LinJesUxUs/TermoHumi/KiCad/TermoHumi/TermoHumi.kicad_pcb

## KiCad design KiCad/TermoHumi/TermoHumi.kicad_pcb (2026-10-09)

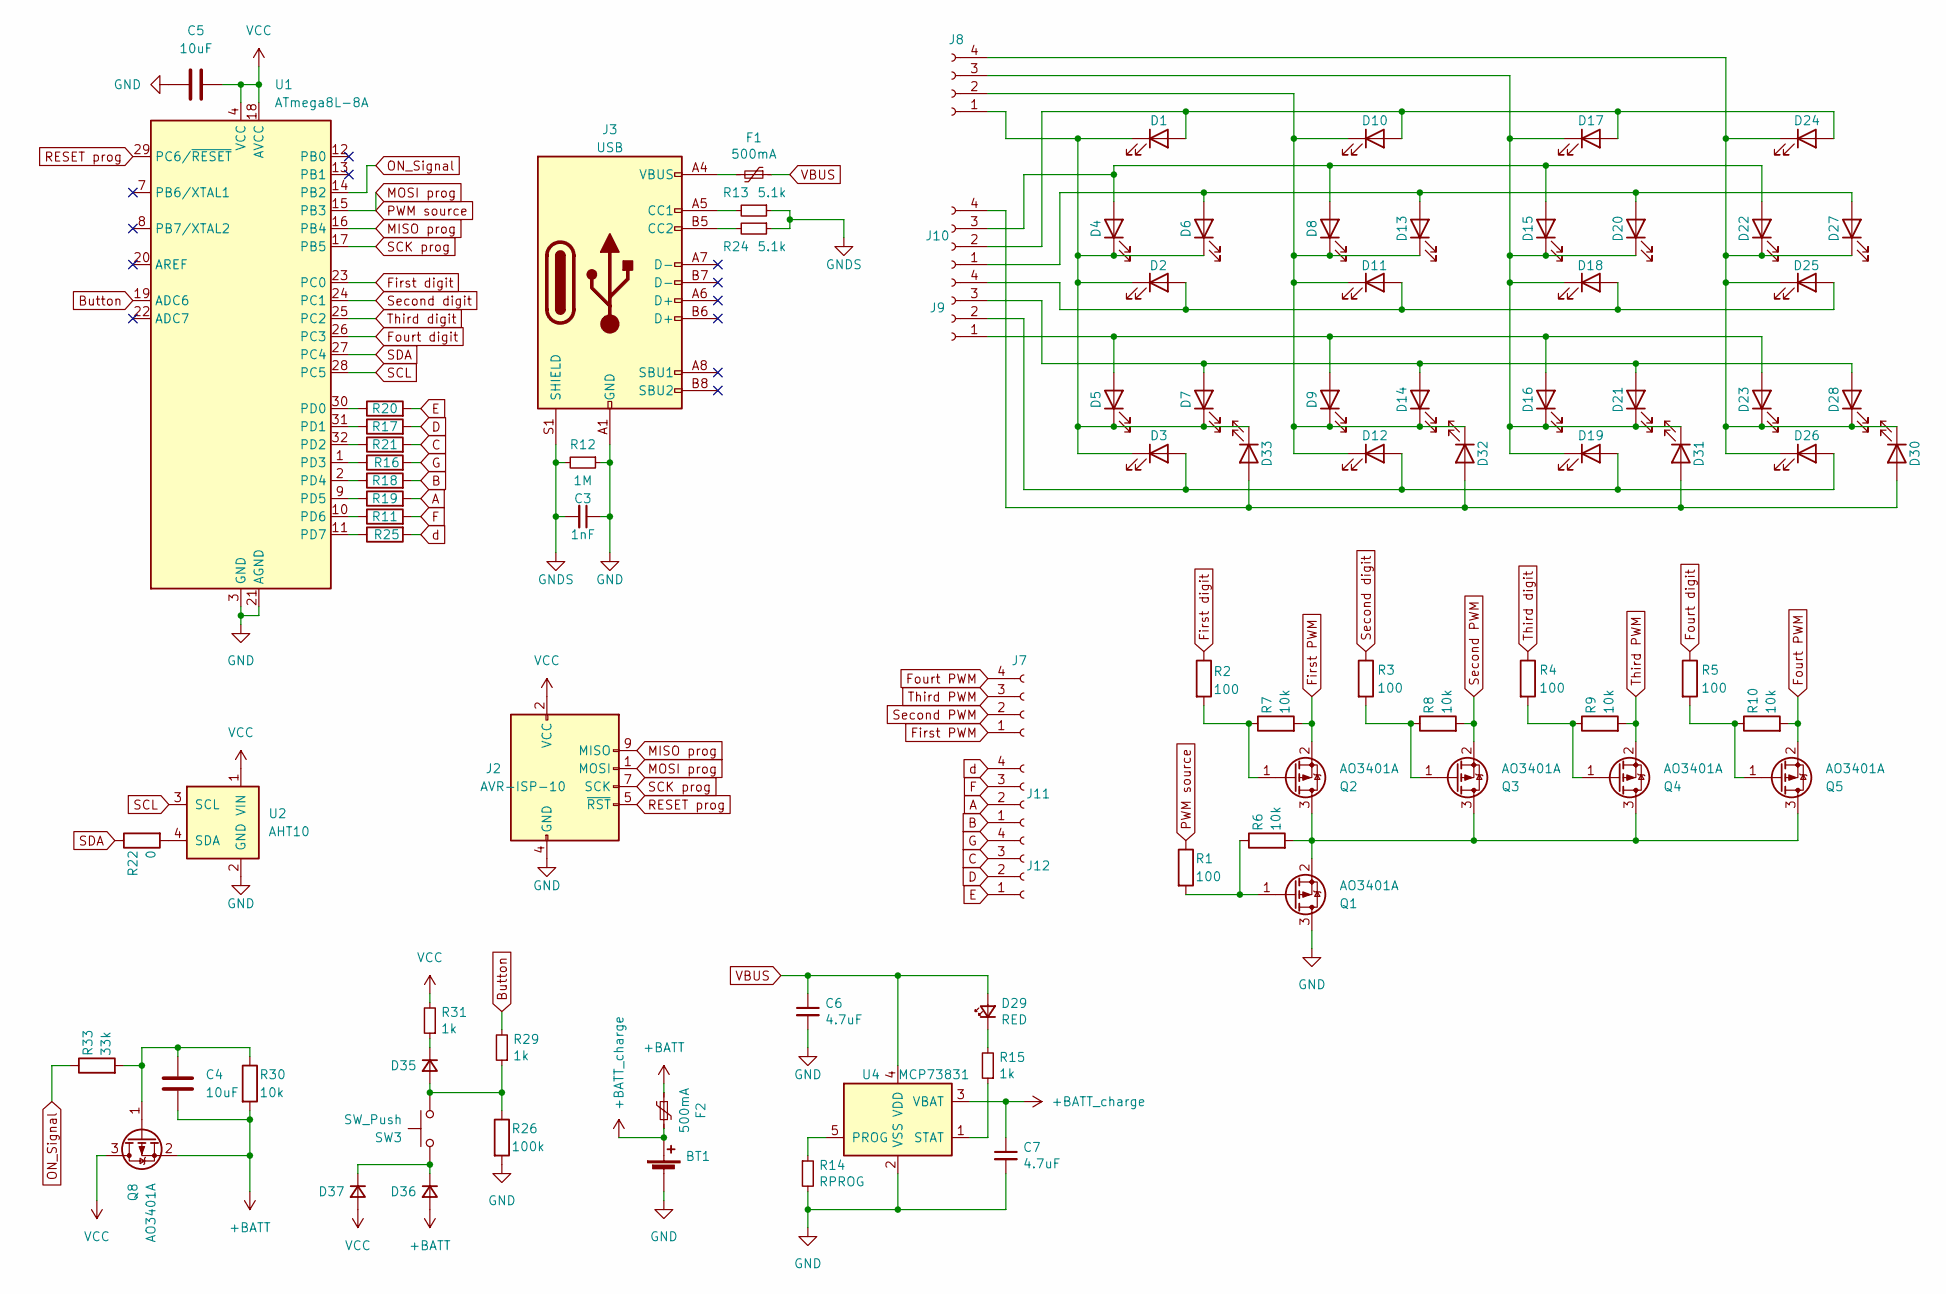
[picture p1: schematic TermoHumi.kicad_sch]

Parts:
BT1: Battery_Cell; PinHeader_1x02_P2.54mm_Vertical
C3: 1nF; C_0603_1608Metric_Pad1.08x0.95mm_HandSolder; LCSC C1588
C4, C5: 10uF; C_0603_1608Metric_Pad1.08x0.95mm_HandSolder
C6, C7: 4.7uF; C_0603_1608Metric_Pad1.08x0.95mm_HandSolder; LCSC C19666
D1, D2, D3, D4, D5, D6, D7, D8, D9, D10, D11, D12, D13, D14, D15, D16, D17, D18, D19, D20, D21, D22, D23, D24, D25, D26, D27, D28, D30, D31, D32, D33: LED; LED_1606_4015Metric_Pad1.42x1.75mm_HandSolder
D29: RED; LED_1606_4015Metric_Pad1.42x1.75mm_HandSolder; LCSC C2286
D35, D36, D37: 1N4148WS; D_SOD-323_HandSoldering; LCSC C57759
F1, F2: 500mA; Fuse_1206_3216Metric_Pad1.42x1.75mm_HandSolder; LCSC C355568
J2: AVR-ISP-10; PinHeader_2x05_P2.54mm_Vertical
J3: USB; USB-C_C168688
J7, J8, J9, J10, J11, J12: Conn_01x04_Socket; PinHeader_1x04_P2.54mm_Vertical
Q1, Q2, Q3, Q4, Q5, Q8: AO3401A; SOT-23
R1, R2, R3, R4, R5: 100; R_0603_1608Metric_Pad0.98x0.95mm_HandSolder
R6, R7, R8, R9, R10, R30: 10k; R_0603_1608Metric_Pad0.98x0.95mm_HandSolder
R11, R16, R17, R18, R19, R20, R21, R25: 220; R_0603_1608Metric_Pad0.98x0.95mm_HandSolder
R12: 1M; R_0603_1608Metric_Pad0.98x0.95mm_HandSolder; LCSC C22935
R13, R24: 5.1k; R_0603_1608Metric_Pad0.98x0.95mm_HandSolder; LCSC C23186
R14: RPROG; R_0603_1608Metric_Pad0.98x0.95mm_HandSolder; LCSC C22978
R15, R29, R31: 1k; R_0603_1608Metric_Pad0.98x0.95mm_HandSolder; LCSC C21190
R22: 0; R_0603_1608Metric_Pad0.98x0.95mm_HandSolder
R26: 100k; R_0603_1608Metric_Pad0.98x0.95mm_HandSolder
R33: 33k; R_0805_2012Metric_Pad1.20x1.40mm_HandSolder
SW3: SW_Push; TS-1086E_TopoR_Hack_HandSolder
U1: ATmega8L-8A; TQFP-32_7x7mm_P0.8mm
U2: AHT10; AHT10_module_x04_P2.54mm
U4: MCP73831; SOT-23-5_HandSoldering; LCSC C14879

Connections:
+BATT: C4.2, D36.2 (A), F2.2, Q8.2 (S), R30.2
+BATT_charge: BT1.1 (+), C7.1, F2.1, U4.3 (VBAT)
A: J11.2, R19.2
B: J11.1, R18.2
Button: R29.2, U1.19 (ADC6)
C: J12.3, R21.2
D: J12.2, R17.2
E: J12.1, R20.2
F: J11.3, R11.2
First PWM: J7.1, Q2.2 (S), R7.2
First digit: R2.1, U1.23 (PC0)
Fourt PWM: J7.4, Q5.2 (S), R10.2
Fourt digit: R5.1, U1.26 (PC3)
G: J12.4, R16.2
GND: BT1.2 (-), C3.1, C5.1, C6.2, C7.2, J2.4 (GND), J2.6 (GND), J2.8 (GND), J2.10 (GND), J3.A1 (GND), J3.A12 (GND), J3.B1 (GND), J3.B12 (GND), Q1.3 (D), R12.1, R14.2, R26.2, U1.3 (GND), U1.5 (GND), U1.21 (AGND), U2.2 (GND), U2.5 (GND), U4.2 (VSS)
GNDS: C3.2, J3.S1 (SHIELD), R12.2, R13.1, R24.1
MISO prog: J2.9 (MISO), U1.16 (PB4)
MOSI prog: J2.1 (MOSI), R1.1, U1.15 (PB3)
unnamed: D1.2 (A), D10.2 (A), D17.2 (A), D24.2 (A), J10.2
unnamed: D1.1 (K), D2.1 (K), D3.1 (K), D4.1 (K), D5.1 (K), D6.1 (K), D7.1 (K), D33.1 (K), J8.1
unnamed: D8.1 (K), D9.1 (K), D10.1 (K), D11.1 (K), D12.1 (K), D13.1 (K), D14.1 (K), D32.1 (K), J8.2
unnamed: D2.2 (A), D11.2 (A), D18.2 (A), D25.2 (A), J9.4
unnamed: D3.2 (A), D12.2 (A), D19.2 (A), D26.2 (A), J9.2
unnamed: D6.2 (A), D13.2 (A), D20.2 (A), D27.2 (A), J10.1
unnamed: D7.2 (A), D14.2 (A), D21.2 (A), D28.2 (A), J9.3
unnamed: D4.2 (A), D8.2 (A), D15.2 (A), D22.2 (A), J10.3
unnamed: D15.1 (K), D16.1 (K), D17.1 (K), D18.1 (K), D19.1 (K), D20.1 (K), D21.1 (K), D31.1 (K), J8.3
unnamed: D5.2 (A), D9.2 (A), D16.2 (A), D23.2 (A), J9.1
unnamed: D22.1 (K), D23.1 (K), D24.1 (K), D25.1 (K), D26.1 (K), D27.1 (K), D28.1 (K), D30.1 (K), J8.4
unnamed: D29.1 (K), R15.2
unnamed: D30.2 (A), D31.2 (A), D32.2 (A), D33.2 (A), J10.4
unnamed: D35.2 (A), R26.1, R29.1, SW3.2
unnamed: D35.1 (K), R31.1
unnamed: D36.1 (K), D37.1 (K), SW3.1
unnamed: F1.2, J3.A4 (VBUS), J3.A9 (VBUS), J3.B4 (VBUS), J3.B9 (VBUS)
unnamed: J3.A5 (CC1), R13.2
unnamed: J3.B5 (CC2), R24.2
unnamed: Q1.1 (G), R1.2, R6.1
unnamed: Q1.2 (S), Q2.3 (D), Q3.3 (D), Q4.3 (D), Q5.3 (D), R6.2
unnamed: Q2.1 (G), R2.2, R7.1
unnamed: Q3.1 (G), R3.2, R8.1
unnamed: Q4.1 (G), R4.2, R9.1
unnamed: Q5.1 (G), R5.2, R10.1
unnamed: C4.1, Q8.1 (G), R30.1, R33.2
unnamed: R20.1, U1.30 (PD0)
unnamed: R17.1, U1.31 (PD1)
unnamed: R21.1, U1.32 (PD2)
unnamed: R16.1, U1.1 (PD3)
unnamed: R18.1, U1.2 (PD4)
unnamed: R19.1, U1.9 (PD5)
unnamed: R11.1, U1.10 (PD6)
unnamed: R25.1, U1.11 (PD7)
unnamed: R22.2, U2.4 (SDA)
unnamed: R14.1, U4.5 (PROG)
unnamed: R15.1, U4.1 (STAT)
ON_Signal: R33.1, U1.14 (PB2)
RESET prog: J2.5 (~RST), U1.29 (PC6/~RESET)
SCK prog: J2.7 (SCK), U1.17 (PB5)
SCL: U1.28 (PC5), U2.3 (SCL)
SDA: R22.1, U1.27 (PC4)
Second PWM: J7.2, Q3.2 (S), R8.2
Second digit: R3.1, U1.24 (PC1)
Third PWM: J7.3, Q4.2 (S), R9.2
Third digit: R4.1, U1.25 (PC2)
VBUS: C6.1, D29.2 (A), F1.1, U4.4 (VDD)
VCC: C5.2, D37.2 (A), J2.2 (VCC), Q8.3 (D), R31.2, U1.4 (VCC), U1.6 (VCC), U1.18 (AVCC), U2.1 (VIN)
d: J11.4, R25.2

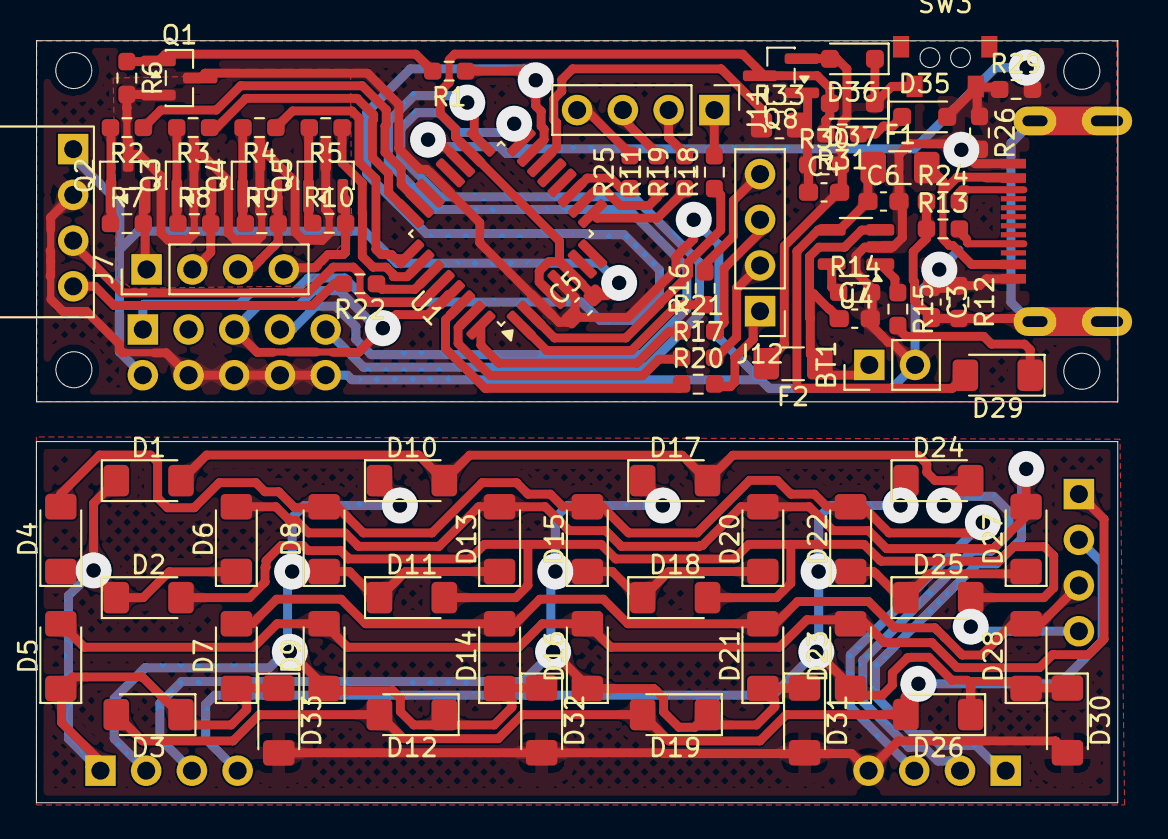
[picture p2: board TermoHumi.kicad_pcb from above]

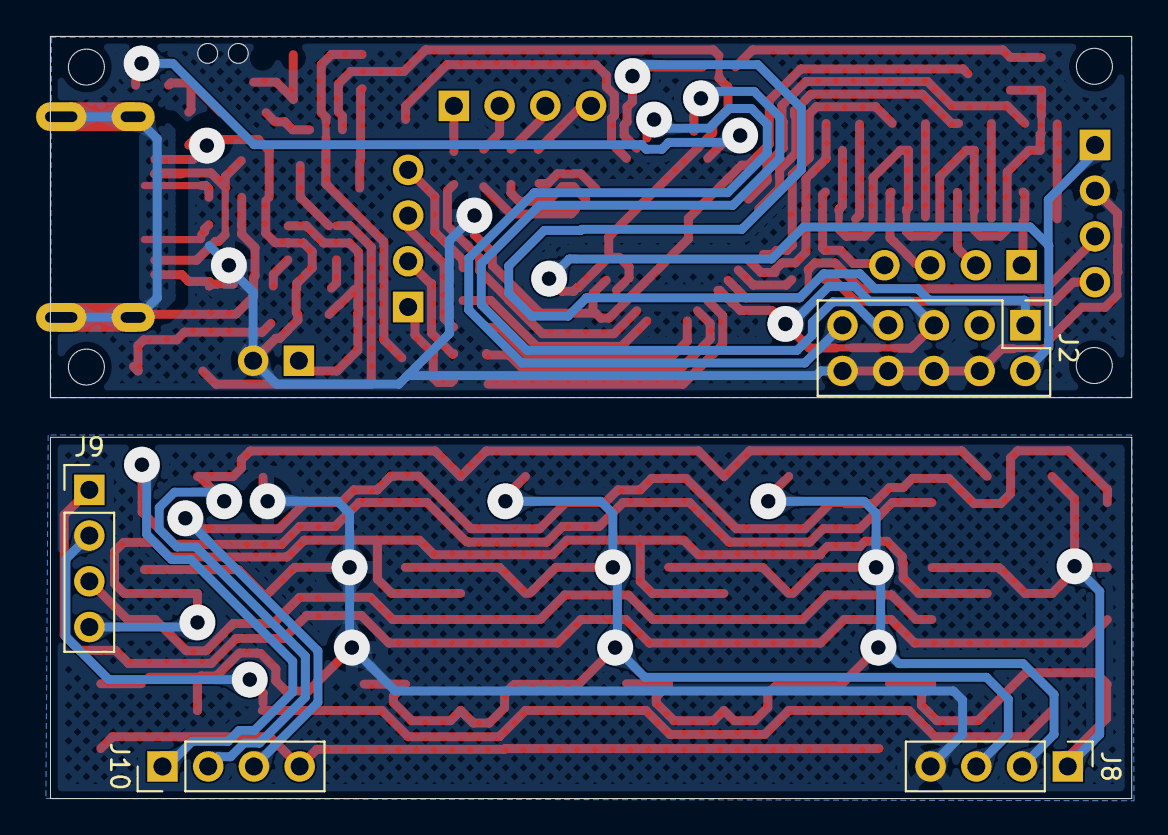
[picture p3: board TermoHumi.kicad_pcb from below]

Board: 2 copper layers, 60.1 x 42.3 mm, 91 parts (4 on the bottom side), 67 nets.
