LinJesUxUs/TermoHumi/(commit log)

2026-08-05 Massive refactor. Added: PWM brightness control over button, floating point on display. Fix display timing
    [AHT10.cpp, AHT10.h, main.cpp]
2026-08-05 Fix temperature calculation bug
    [AHT10.cpp]
2026-08-05 Change measuring and temp/humi switching delay
2026-08-06 Fix ADC initialisation, and ADC conversion reading.
    [main.cpp]
2026-08-10 Edited button debounce count
2026-10-09 Add feature: PB2 as ON key. Based on mcu timer.
2026-10-09 Add KiCad project
    [TermoHumi.kicad_pcb, TermoHumi.kicad_sch]
